nandercarmo/My-IlluminanceMeter/(commit log)

2021-02-17 Adição da primeira versão do sistema de aquisição de dados.
2021-02-17 Correção de erro no start da Serial. Adição de comentários para debug.
2021-02-20 Adição da interface gráfica feita em QT. Correção do código da aquisição para ser controlada pela interface através da manipulação dos registradores.
2021-02-25 Correção do recebimento de dados via serial para alta frequência.
2021-03-28 Correção da rotina de reconfiguração dos registradores da aquisição para interromper as interrupções. Adição de outro gráfico na interface. Correção do recebimento de dados pela serial. Adição das fu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
2021-04-07 Adição do gif de demonstração do sistema.
